FarnamAdelkhani/DualChannel-Amplifier-EagleCAD/Amp (2).JPG

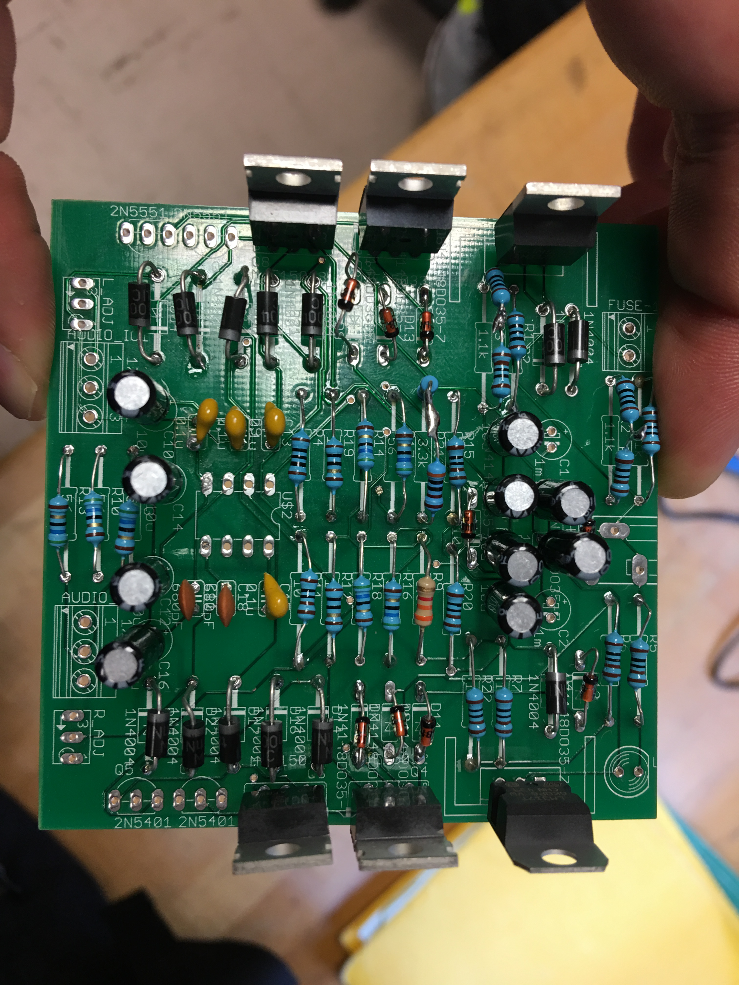
Amp (2).JPG
