FarnamAdelkhani/DualChannel-Amplifier-EagleCAD/Amp (1).JPG

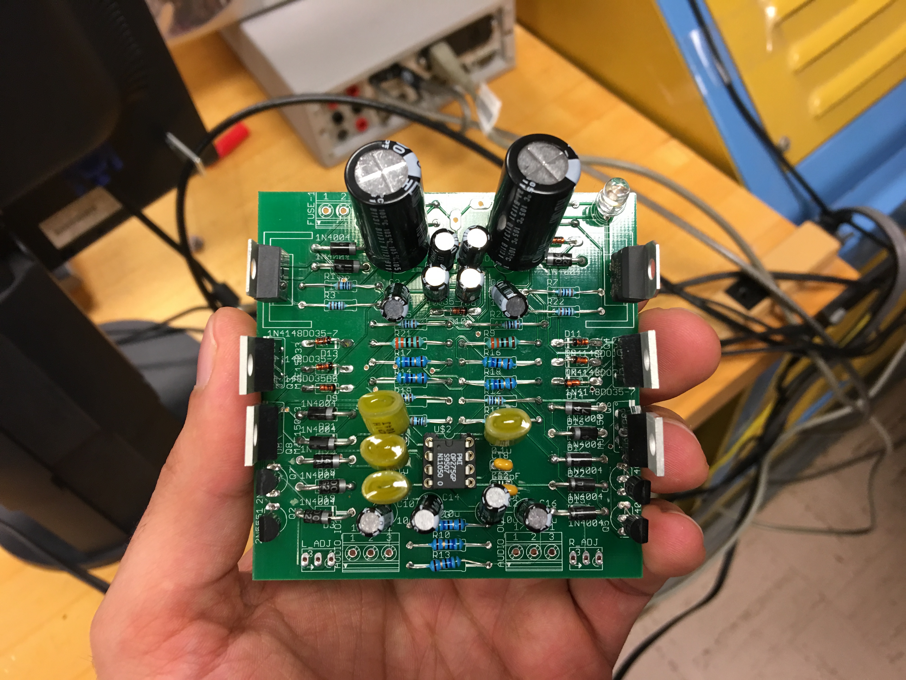
Amp (1).JPG
