FarnamAdelkhani/DualChannel-Amplifier-EagleCAD/README.md

# DualChannel-Amplifier-EagleCAD
Design amplifier design in Eagle, then export Gerber files for printing. Order components and solder away.
