FarnamAdelkhani/DualChannel-Amplifier-EagleCAD/PartsList.xlsx

Sheet: BOM v1
Position | Item Name | Item Description
D3 | 1N4004 | diode (DO-41)
C11 | 1000uF | electrolytic capacitor
C13 | 10uF | electrolytic capacitor
IC1 | LM317 | positive voltage regulator/DC supply (TO-220)
C15 | 10uF | electrolytic capacitor
R21 | 100 ohm | resistor
R22 | 1.1k ohm | resistor
D1 | 1N4004 | diode (DO-41)
C17 | 10uF | electrolytic capacitor
LED1 | LED | LED
R25 | 1k ohm | resistor
D4 | 1N4004 | diode (DO-41)
C12 | 1000uF | electrolytic capacitor
C14 | 10uF | electrolytic capacitor
C16 | 10uF | electrolytic capacitor
V_REG_337 | LM337 | negative voltage regulator/DC supply (TO-220)
R23 | 1.1k ohm | resistor
R24 | 100 ohm | resistor
D2 | 1N4004 | diode (DO-41)
C18 | 10uF | electrolytic capacitor
D5 | 1N4148 | diode (DO-35)
C1 | 0.1uF | ceramic capacitor
C4 | 10uF | electrolytic capacitor
R2 | 1k ohm | resistor
R5 | 3.3k ohm | resistor
D7 | 1N4148 | diode (DO-35)
D8 | 1N4148 | diode (DO-35)
R6 | 56 ohm | resistor
Q1 | 2N5401 | PNP transistor (TO-92)
D11 | 1N4148 | diode (DO-35)
D12 | 1N4148 | diode (DO-35)
Q3 | MJE15032 | NPN transistor (TO-220AB or TO-220)
R8 | 10 ohm | resistor
IC2 | AD797N | op-amp (PDIP)
D6 | 1N4148 | diode (DO-35)
C2 | 680pF | ceramic capacitor
C3 | 0.1uF | ceramic capacitor
R3 | 1k ohm | resistor
C5 | 10uF | electrolytic capacitor
R4 | 1k ohm | resistor
D9 | 1N4148 | diode (DO-35)
D10 | 1N4148 | diode (DO-35)
D13 | 1N4148 | diode (DO-35)
Q2 | 2N5551 | NPN transistor (TO-92)
R7 | 56 ohm | resistor
R9 | 10 ohm | resistor
Q4 | MJE15033 | PNP transistor (TO-220AB or TO-220)
D14 | 1N4148 | diode (DO-35)
C6 | 0.1uF | ceramic capacitor
C9 | 10uF | electrolytic capacitor
R11 | 1k ohm | resistor
R14 | 3.3k ohm | resistor
D16 | 1N4148 | diode (DO-35)
D17 | 1N4148 | diode (DO-35)
R15 | 56 ohm | resistor
Q5 | 2N5401 | PNP transistor (TO-92)
D20 | 1N4148 | diode (DO-35)
D21 | 1N4148 | diode (DO-35)
Q7 | MJE15032 | NPN transistor (TO-220AB or TO-220)
R17 | 10 ohm | resistor
IC3 | AD797N | op-amp (PDIP)
D15 | 1N4148 | diode (DO-35)
C7 | 680pF | ceramic capacitor
C8 | 0.1uF | ceramic capacitor
R12 | 1k ohm | resistor
C10 | 10uF | electrolytic capacitor
R13 | 1k ohm | resistor
D18 | 1N4148 | diode (DO-35)
D19 | 1N4148 | diode (DO-35)
D22 | 1N4148 | diode (DO-35)
Q6 | 2N5551 | NPN transistor (TO-92)
R16 | 56 ohm | resistor
R18 | 10 ohm | resistor
Q8 | MJE15033 | PNP transistor (TO-220AB or TO-220)

Sheet: BOM v2
Name | Part Description | Qty | Digi-Key Part Number
0.1uF | ceramic capacitor | 4 | 493-3467-ND
1.1k ohm | resistor | 2 | PPC1.10KXCT-ND
10 ohm | resistor | 4 | PPC10.0XCT-ND
100 ohm | resistor | 2 | PPC100XCT-ND
1000uF | electrolytic capacitor | 2 | 493-14486-ND
10uF | electrolytic capacitor | 10 | 493-14344-1-ND
1k ohm | resistor | 7 | PPC1.00KXCT-ND
1N4004 | diode (DO-41) | 4 | 1N4004FSCT-ND
1N4148 | diode (DO-35) | 18 | 1N4148FS-ND
2N5401 | PNP transistor (TO-92) | 2 | 2N5401CS-ND
2N5551 | NPN transistor (TO-92) | 2 | 2N5551CS-ND
3.3k ohm | resistor | 2 | A105959CT-ND
56 ohm | resistor | 4 | PPC1D56.0CT-ND
680pF | ceramic capacitor | 2 | BC1023CT-ND
AD797N | op-amp (PDIP) | 2 | AD797ANZ-ND
LED | LED | 1 | 67-2062-ND
LM317 | positive voltage regulator/DC supply (TO-220) | 1 | 497-1575-5-ND
LM337 | negative voltage regulator/DC supply (TO-220) | 1 | LM337TGOS-ND
MJE15032 | NPN transistor (TO-220AB or TO-220) | 2 | MJE15032GOS-ND
MJE15033 | PNP transistor (TO-220AB or TO-220) | 2 | MJE15033GOS-ND
Total Number of Components |  | 74

Sheet: BOM v3
Name | Part Description | Qty | Digi-Key Part Number
0.1uF | ceramic capacitor | 4 | 493-3467-ND
1.1k ohm | resistor | 2 | PPC1.10KXCT-ND
10 ohm | resistor | 4 | PPC10.0XCT-ND
100 ohm | resistor | 2 | PPC100XCT-ND
1000uF | electrolytic capacitor | 2 | 493-14486-ND
10uF | electrolytic capacitor | 10 | 493-14344-1-ND
1k ohm | resistor | 7 | PPC1.00KXCT-ND
1N4004 | diode (DO-41) | 4 | 1N4004FSCT-ND
1N4148 | diode (DO-35) | 18 | 1N4148FS-ND
2N5401 | PNP transistor (TO-92) | 2 | 2N5401CS-ND
2N5551 | NPN transistor (TO-92) | 2 | 2N5551CS-ND
3.3k ohm | resistor | 2 | A105959CT-ND
56 ohm | resistor | 4 | PPC1D56.0CT-ND
680pF | ceramic capacitor | 2 | BC1023CT-ND
AD797N | op-amp (PDIP) | 2 | AD797ANZ-ND
LED | LED | 1 | 67-2062-ND
LM317 | positive voltage regulator/DC supply (TO-220) | 1 | 497-1575-5-ND
LM337 | negative voltage regulator/DC supply (TO-220) | 1 | LM337TGOS-ND
MJE15032 | NPN transistor (TO-220AB or TO-220) | 2 | MJE15032GOS-ND
MJE15033 | PNP transistor (TO-220AB or TO-220) | 2 | MJE15033GOS-ND
Total Number of Components |  | 74

Sheet: BOM v4
Name | Part Description | Qty | Digi-Key Part Number
0.1uF | ceramic capacitor | 8 | 493-3467-ND
1.1k ohm | resistor | 4 | PPC1.10KXCT-ND
10 ohm | resistor | 8 | PPC10.0XCT-ND
100 ohm | resistor | 4 | PPC100XCT-ND
1000uF | electrolytic capacitor | 4 | 493-14486-ND
10uF | electrolytic capacitor | 20 | 493-14344-1-ND
1k ohm | resistor | 14 | PPC1.00KXCT-ND
1N4004 | diode (DO-41) | 8 | 1N4004FSCT-ND
1N4148 | diode (DO-35) | 36 | 1N4148FS-ND
2N5401 | PNP transistor (TO-92) | 4 | 2N5401CS-ND
2N5551 | NPN transistor (TO-92) | 4 | 2N5551CS-ND
3.3k ohm | resistor | 4 | A105959CT-ND
56 ohm | resistor | 8 | PPC1D56.0CT-ND
680pF | ceramic capacitor | 4 | BC1023CT-ND
AD797N | op-amp (PDIP) | 4 | AD797ANZ-ND
LED | LED | 2 | 67-2062-ND
LM317 | positive voltage regulator/DC supply (TO-220) | 2 | 497-1575-5-ND
LM337 | negative voltage regulator/DC supply (TO-220) | 2 | LM337TGOS-ND
MJE15032 | NPN transistor (TO-220AB or TO-220) | 4 | MJE15032GOS-ND
MJE15033 | PNP transistor (TO-220AB or TO-220) | 4 | MJE15033GOS-ND
Total Number of Components |  | 148
