FarnamAdelkhani/DualChannel-Amplifier-EagleCAD/Project Schematic.pdf

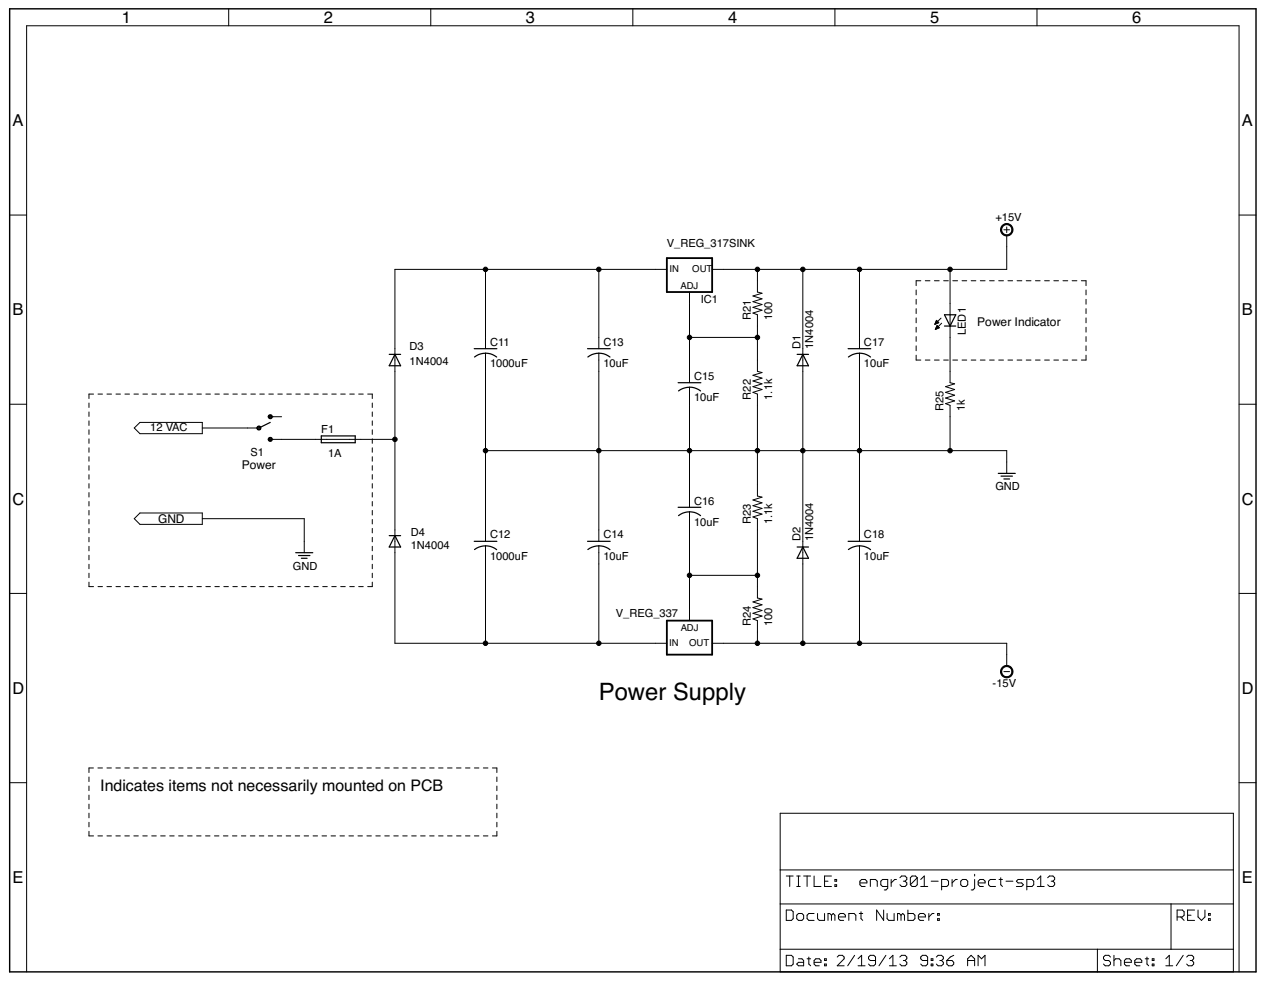
[picture p3: page 1]

Indicates items not necessarily mounted on PCB

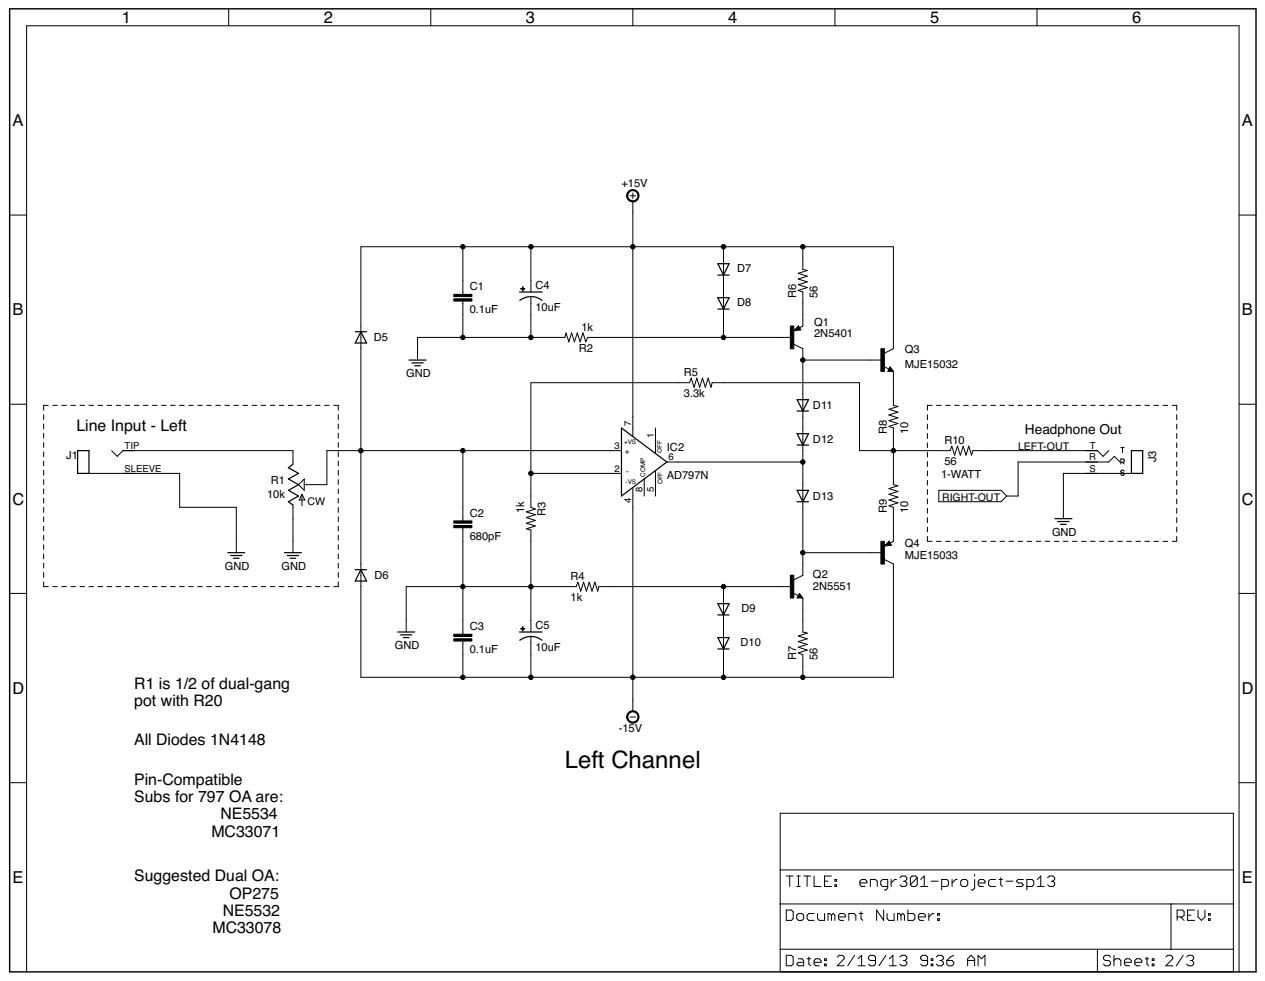
[picture p4: page 2]

R1 is 1/2 of dual-gang
pot with R20

Pin-Compatible
Subs for 797 OA are:

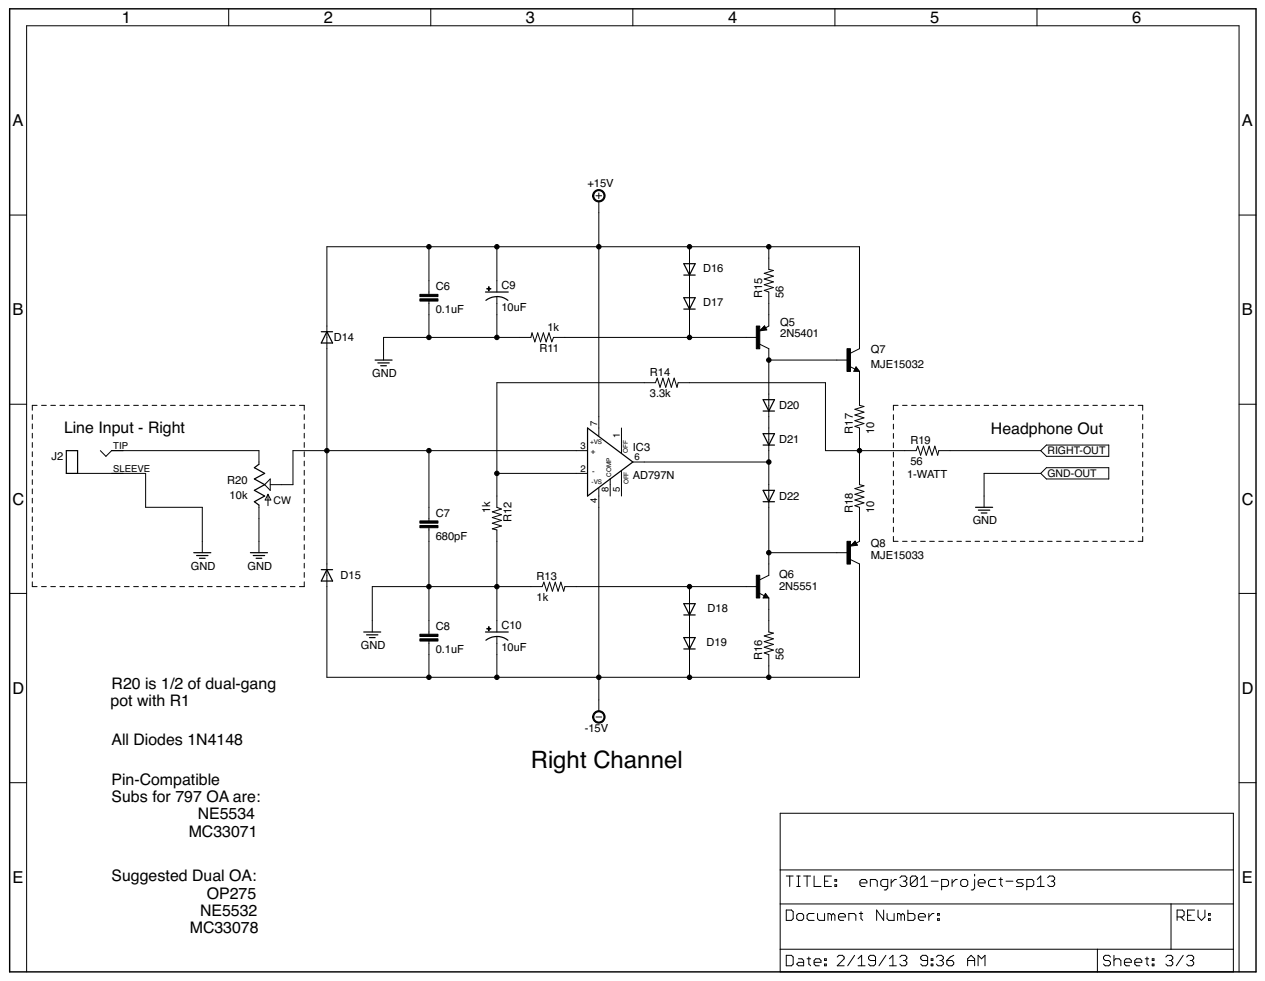
[picture p5: page 3]

R20 is 1/2 of dual-gang
pot with R1

Pin-Compatible
Subs for 797 OA are:
