FarnamAdelkhani/DualChannel-Amplifier-EagleCAD/Final/Final project combined.brd

## EAGLE design Final/Final project combined.brd (2018-06-06)

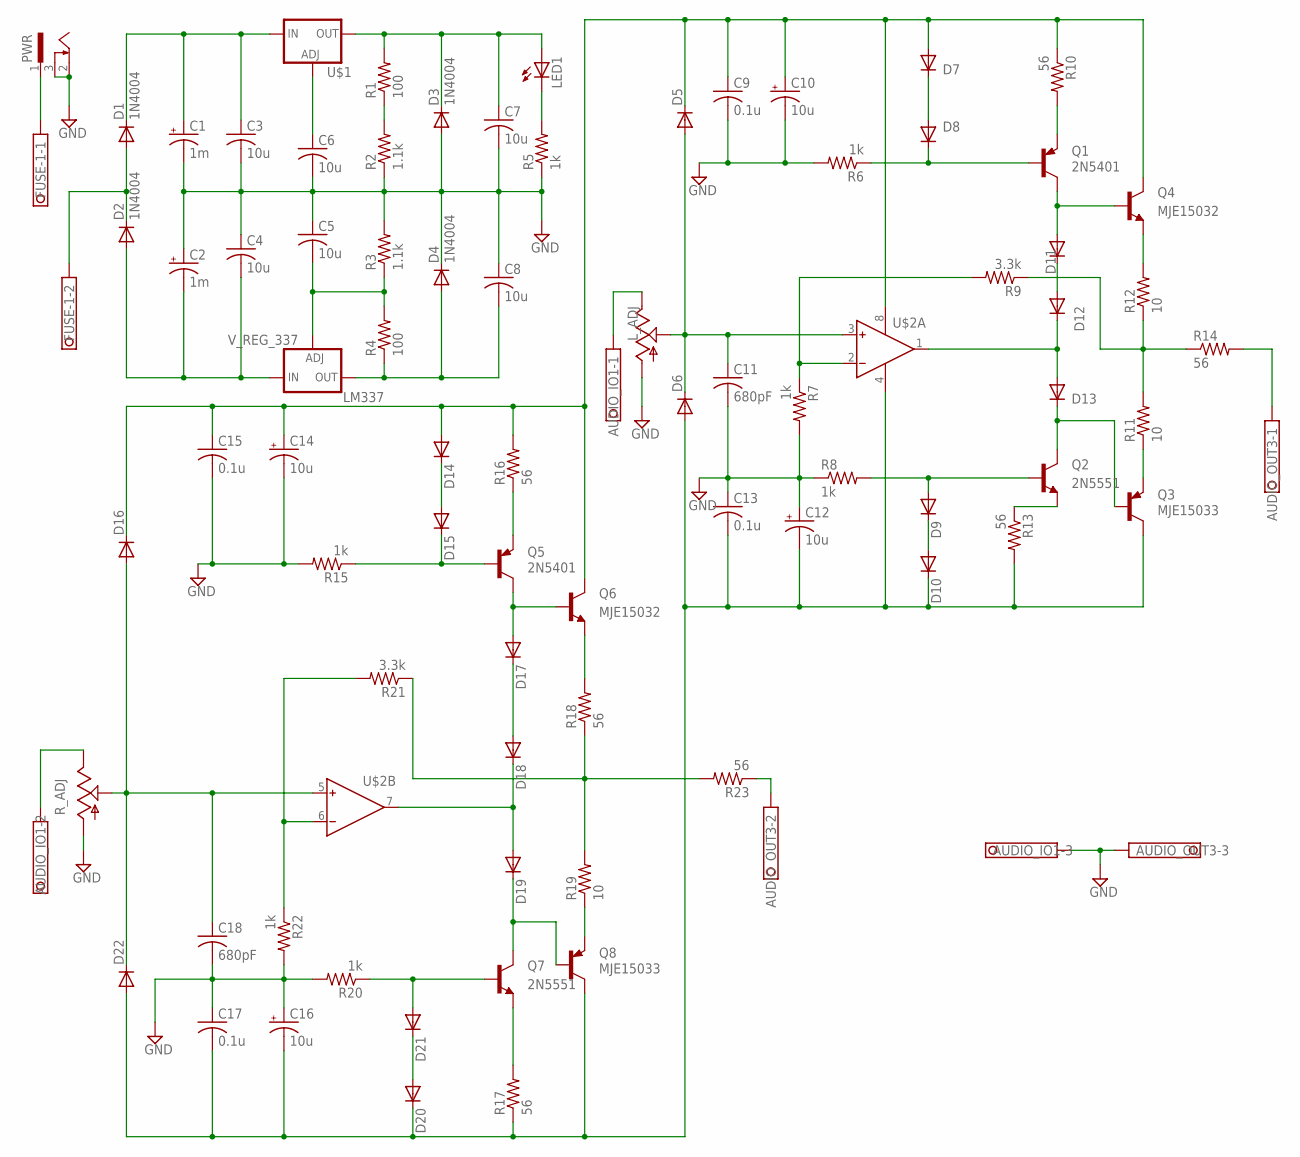
[picture p6: schematic Final project combined.sch]

Parts:
AUDIO_IO1: 1751251
AUDIO_OUT3: 1751251
C1, C2: 1m; E2-5
C3, C4, C5, C6, C7, C8: 10u; C025-024X044
C9, C13, C15, C17: 0.1u; C025-024X044
C10, C12, C14, C16: 10u; E2-5
C11, C18: 680pF; C025-024X044
D1, D2, D3, D4, D14, D15, D16, D17, D18, D19, D20, D21, D22: 1N4004; DO41-10
D5, D6, D7, D8, D9, D10, D11, D12, D13: 1N4148DO35-7; DO35-7
FUSE-1: 1751248
LED1: LED5MM
LM337: V_REG_337; TO220-ADJ-NEG
L_ADJ: TRIM_US-B64Y; B64Y
PWR: SCD-014A; SCD-014-A
Q1, Q5: 2N5401
Q2, Q7: 2N5551
Q3, Q8: MJE15033; TO220V
Q4, Q6: MJE15032; TO220V
R1, R4: 100; 0207/15
R2, R3: 1.1k; 0207/15
R5, R6, R7, R8, R15, R20, R22: 1k; 0207/15
R9, R21: 3.3k; 0207/15
R10, R13, R14, R16, R17, R18, R23: 56; 0207/15
R11, R12, R19: 10; 0207/15
R_ADJ: TRIM_US-B64Y; B64Y
U$1: V_REG_317SINK; TO220-ADJ
U$2: OP275'P'; DIL08

Connections:
GND: AUDIO_IO1.3, AUDIO_OUT3.3, C1.-, C2.+, C3.2, C4.1, C5.1, C6.2, C7.2, C8.1, C9.2, C10.-, C11.2, C12.+, C13.1, C14.-, C15.2, C16.+, C17.1, C18.2, D3.A, D4.C, L_ADJ.A, PWR.2, PWR.3, R2.1, R3.2, R5.1, R6.2, R7.2, R8.1, R15.2, R20.2, R22.2, R_ADJ.A
unnamed: D7.C, D8.A
unnamed: R1.1, R2.2
unnamed: C11.1, D5.A, D6.C, L_ADJ.S, U$2.3 (IN+)
unnamed: D11.A, Q1.C, Q4.1 (B)
unnamed: C9.1, C10.+, C14.+, C15.1, D5.C, D7.A, D14.A, D16.C, Q4.2 (C), Q6.2 (C), R10.1, R16.2, U$2.8 (V+)
unnamed: D11.C, D12.A
unnamed: D1.A, D2.C, FUSE-1.2
unnamed: D17.A, Q5.C, Q6.1 (B)
unnamed: C2.-, C4.2, D2.A, LM337.IN
unnamed: C1.+, C3.1, D1.C, U$1.IN
unnamed: D8.C, Q1.B, R6.1
unnamed: R7.1, R9.2, U$2.2 (IN-)
unnamed: D9.A, Q2.B, R8.2
unnamed: D9.C, D10.A
unnamed: Q2.E, R13.1
unnamed: D13.C, Q2.C, Q3.1 (B)
unnamed: D12.C, D13.A, U$2.1 (OUT)
unnamed: R9.1, R11.2, R12.1, R14.1
unnamed: Q3.3 (E), R11.1
unnamed: Q4.3 (E), R12.2
unnamed: C6.1, U$1.ADJ
unnamed: Q1.E, R10.2
unnamed: FUSE-1.1, PWR.1
unnamed: D14.C, D15.A
unnamed: D15.C, Q5.B, R15.1
unnamed: Q5.E, R16.1
unnamed: Q6.3 (E), R18.2
unnamed: D17.C, D18.A
unnamed: Q8.3 (E), R19.1
unnamed: D19.C, Q7.C, Q8.1 (B)
unnamed: D18.C, D19.A, U$2.7 (OUT)
unnamed: D21.A, Q7.B, R20.1
unnamed: D20.A, D21.C
unnamed: R18.1, R19.2, R21.1, R23.2
unnamed: R21.2, R22.1, U$2.6 (IN-)
unnamed: C18.1, D16.A, D22.C, R_ADJ.S, U$2.5 (IN+)
unnamed: Q7.E, R17.2
unnamed: AUDIO_IO1.2, R_ADJ.E
unnamed: C12.-, C13.2, C16.-, C17.2, D6.A, D10.C, D20.C, D22.A, Q3.2 (C), Q8.2 (C), R13.2, R17.1, U$2.4 (V-)
unnamed: AUDIO_IO1.1, L_ADJ.E
unnamed: C8.2, D4.A, LM337.OUT, R4.1
unnamed: C5.2, LM337.ADJ, R3.1, R4.2
unnamed: LED1.K (C), R5.2
unnamed: C7.1, D3.C, LED1.A, R1.2, U$1.OUT
unnamed: AUDIO_OUT3.2, R23.1
unnamed: AUDIO_OUT3.1, R14.2

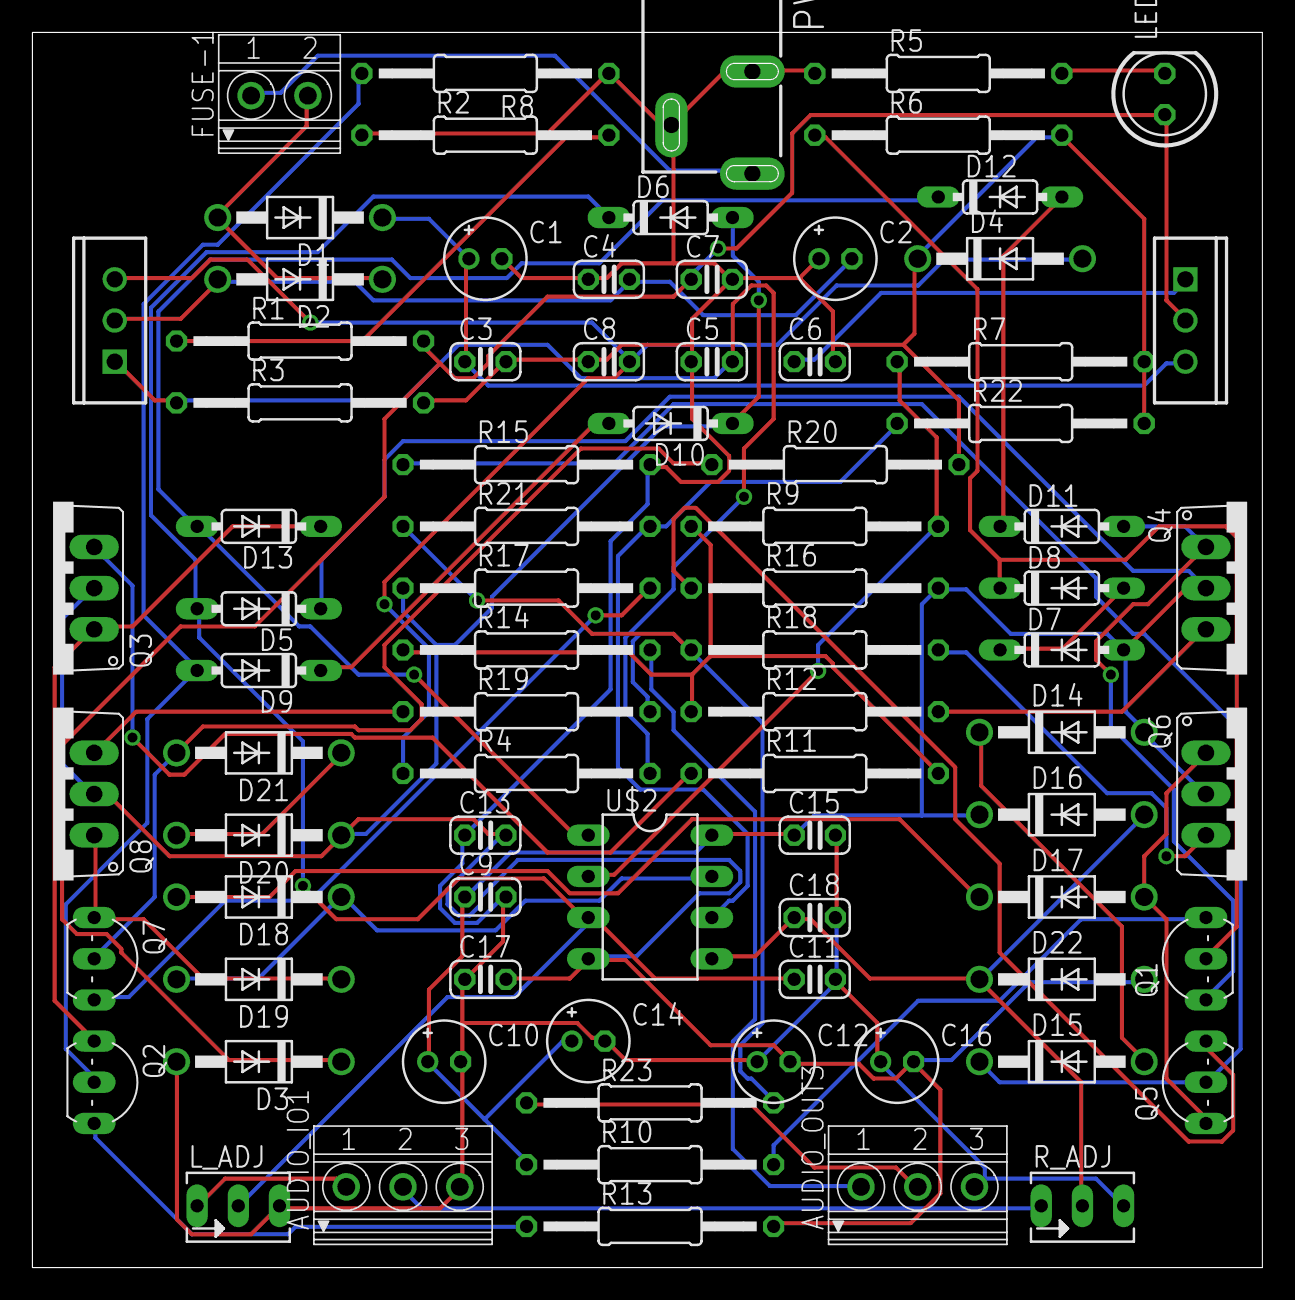
[picture p7: board Final project combined.brd from above]

Board: 2 copper layers, 75.9 x 76.2 mm, 81 parts (0 on the bottom side), 47 nets.
